konkers/cuttlefish/README.md

# Cuttlefish

A drawing of a cuttlefish

An [RP2040](https://www.raspberrypi.com/documentation/microcontrollers/rp2040.html)
based controller for the [LumenPnP Feeder](https://github.com/opulo-inc/feeder).

## Cloning

This repo uses submodule to pull in external dependencies and needs to be recursivly cloned:

```bash
git clone --recurse-submodules https://github.com/konkers/cuttlefish 
```

## PCB

The main pcb is designed in [KiCad](kicad.org).  Becase I use the experimental
HTTP Library support, a nightly version of KiCad is needed.

The [schematic](https://kicanvas.org/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) and
[layout](https://kicanvas.org/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)
can be viewed through KiCanvas.

### Front

front of the cuttlefish pcb 

### Back

front of the cuttlefish pcb

## Firmware

Firmware has not been written yet.  Check back for updates.
