konkers/cuttlefish/(list of files, cad)

Other CAD files:
pcb/main/board_outline.FCStd
