konkers/cuttlefish/pcb/main/cuttlefish-main.kicad_pcb

## KiCad design pcb/main/cuttlefish-main.kicad_pcb (2023-11-08)

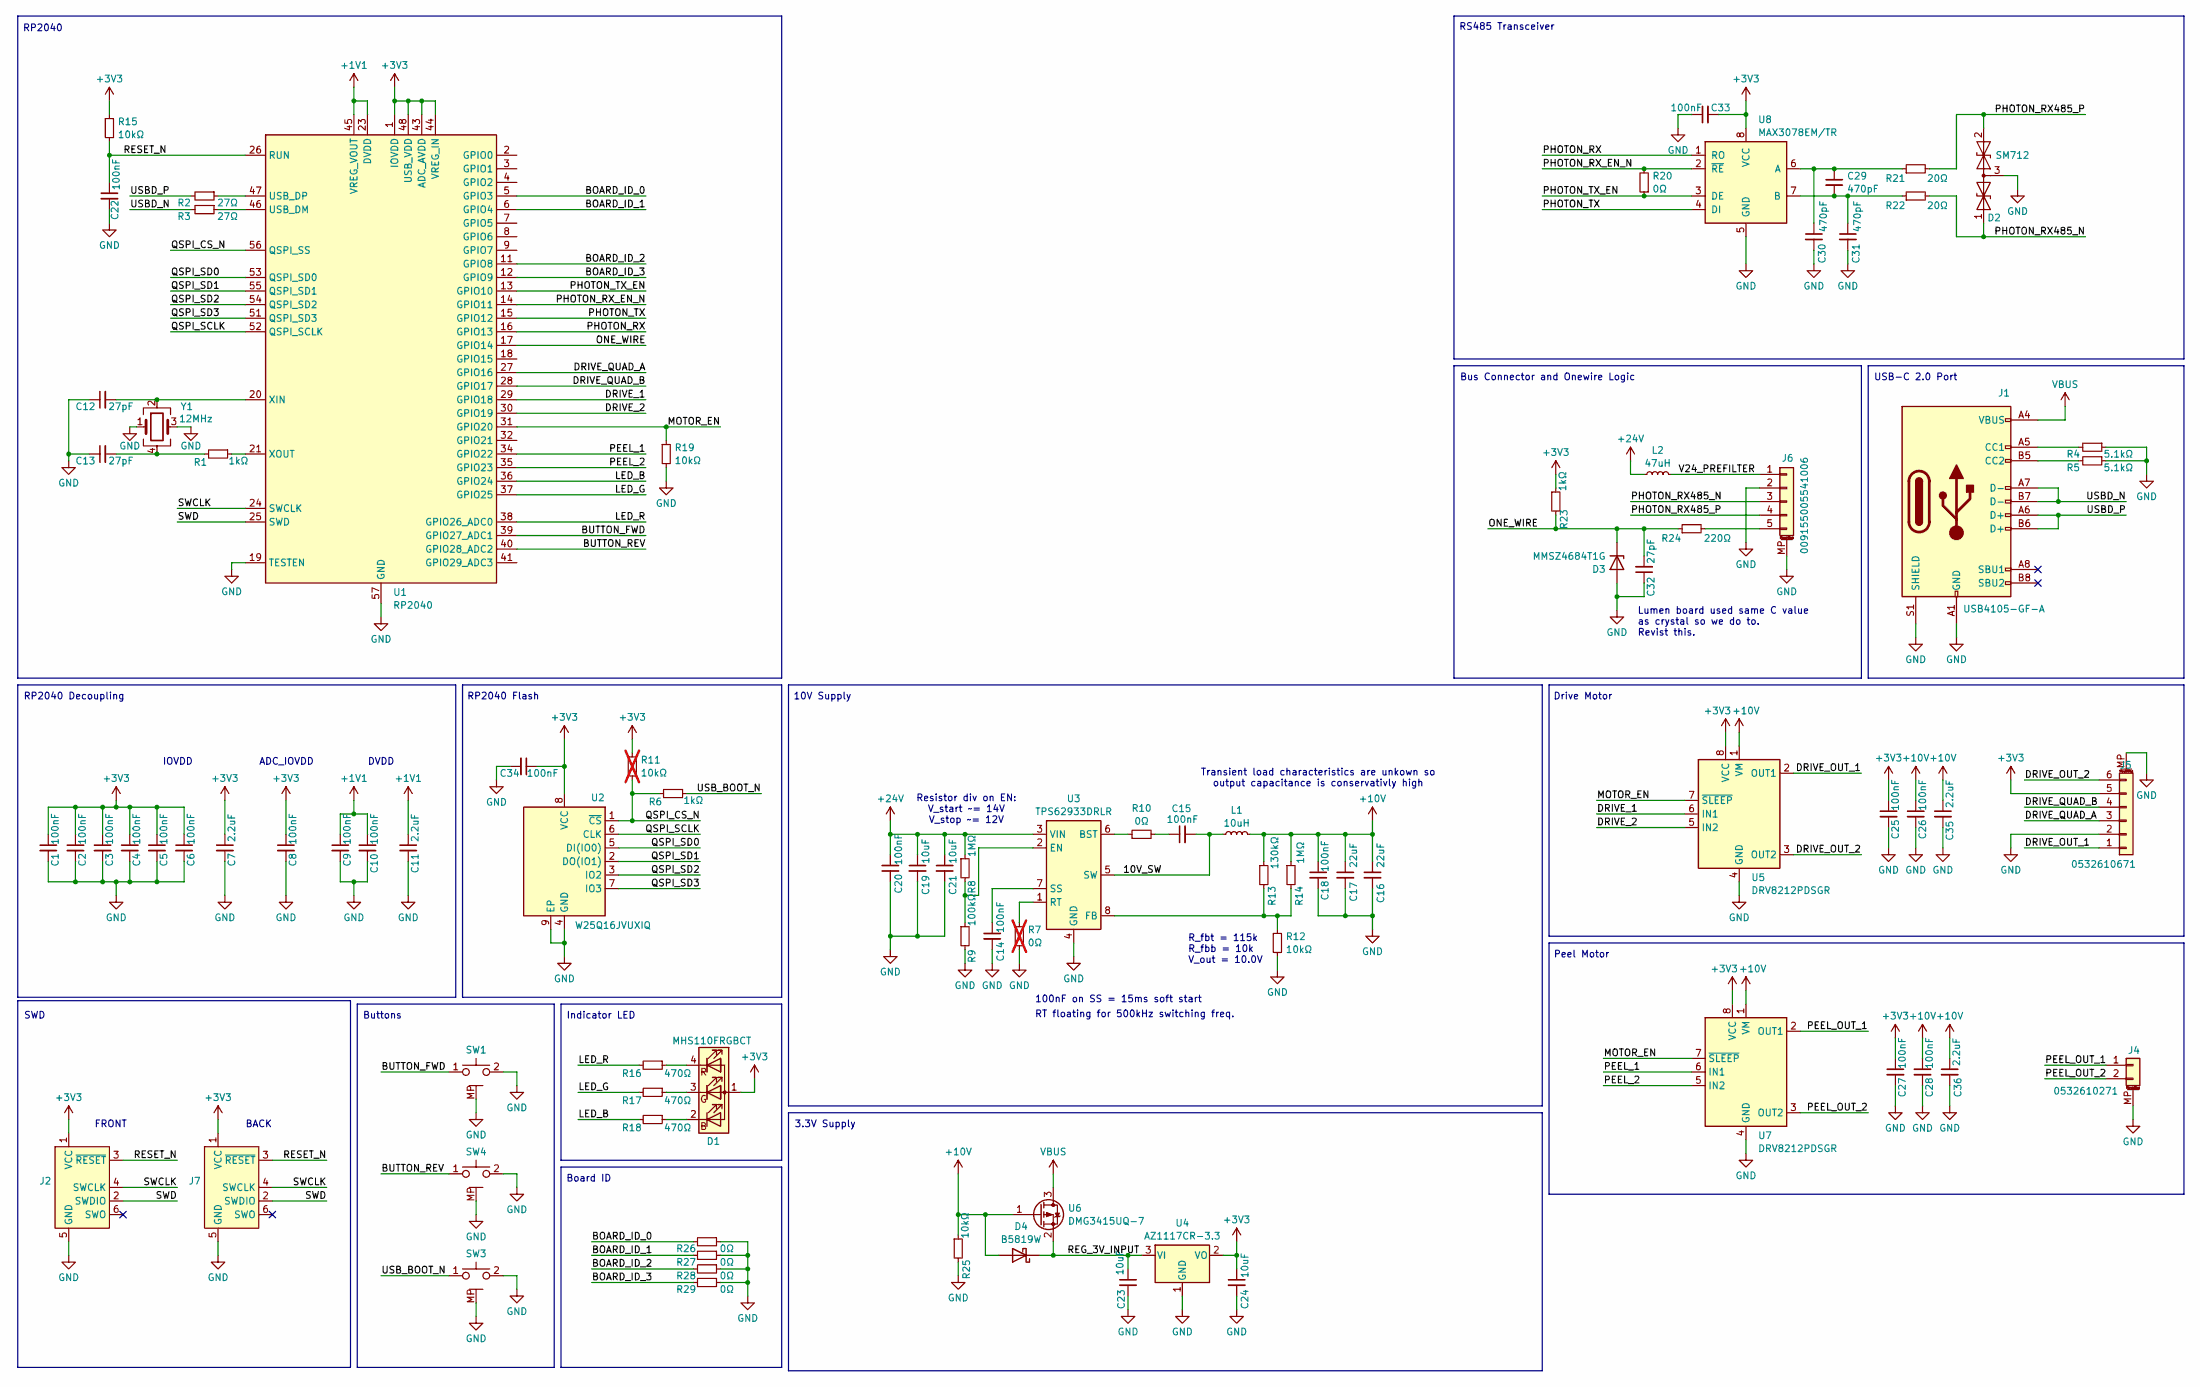
[picture p1: schematic cuttlefish-main.kicad_sch]

Parts:
C1, C2, C3, C4, C5, C6, C8, C9, C10, C14, C15, C18, C20, C22, C25, C26, C27, C28, C33, C34: 100nF; C_0402_1005Metric; Rated Voltage 50V; Tolerance ±10%; Part URL /part/12/
C7, C11, C35, C36: 2.2uF; C_0603_1608Metric; Rated Voltage 50V; Tolerance ±10%; Part URL /part/17/
C12, C13, C32: 27pF; C_0402_1005Metric; Tolerance ±5%; Part URL /part/6/
C16, C17: 22uF; C_0805_2012Metric; Rated Voltage 25V; Tolerance ±20%; Part URL /part/28/
C19, C21, C23, C24: 10uF; C_0603_1608Metric; Rated Voltage 35V; Tolerance ±20%; Part URL /part/29/
C29, C30, C31: 470pF; C_0402_1005Metric; Rated Voltage 50V; Tolerance ±10%; Part URL /part/39/
D1: MHS110FRGBCT; MEIHUA_MHS110FRGBCT; Part URL /part/33/
D2: SM712; SOT-23; Breakdown Voltage 13.3V; Clamping Voltage 21V; Part URL /part/41/
D3: MMSZ4684T1G; D_SOD-123; Forward Voltage 900mV@10mA; Rated Voltage 3.3 V; Part URL /part/45/
D4: B5819W; D_SOD-123; Forward Voltage 690mV@1A; Rated Voltage 40 V; Part URL /part/49/
J1: USB4105-GF-A; USB_C_Receptacle_GCT_USB4105-xx-A_16P_TopMnt_Horizontal; Part URL /part/15/
J2: Tag-Connect_TC2030-IDC-NL_2x03_P1.27mm_Vertical
J4: 0532610271; Molex_PicoBlade_53261-0271_1x02-1MP_P1.25mm_Horizontal; Part URL /part/37/
J5: 0532610671; Molex_PicoBlade_53261-0671_1x06-1MP_P1.25mm_Horizontal; Part URL /part/36/
J6: 009155005541006; AVX_009155005541006; Part URL /part/43/
J7: Conn_ARM_SWD_TagConnect_TC2030-NL; Tag-Connect_TC2030-IDC-NL_2x03_P1.27mm_Vertical
L1: 10uH; Inductor_SMD_7.0mm_6.7mm_2.8mm; Tolerance ±20%; Part URL /part/46/
L2: 47uH; L_Sunlord_SWPA5020S; Tolerance ±20%; Part URL /part/42/
R1, R6, R23: 1kΩ; R_0402_1005Metric; Tolerance ±1%; Part URL /part/7/
R2, R3: 27Ω; R_0402_1005Metric; Tolerance ±1%; Part URL /part/8/
R4, R5: 5.1kΩ; R_0402_1005Metric; Tolerance ±1%; Part URL /part/9/
R7: 0Ω; R_0402_1005Metric; Tolerance Jumper; Part URL /part/21/; not fitted
R8, R14: 1MΩ; R_0402_1005Metric; Tolerance ±1%; Part URL /part/24/
R9: 100kΩ; R_0402_1005Metric; Tolerance ±1%; Part URL /part/11/
R10, R20, R26, R27, R28, R29: 0Ω; R_0402_1005Metric; Tolerance Jumper; Part URL /part/21/
R11: 10kΩ; R_0402_1005Metric; Tolerance ±1%; Part URL /part/25/; not fitted
R12, R15, R19, R25: 10kΩ; R_0402_1005Metric; Tolerance ±1%; Part URL /part/25/
R13: 130kΩ; R_0402_1005Metric; Tolerance ±1%; Part URL /part/26/
R16, R17, R18: 470Ω; R_0402_1005Metric; Tolerance ±1%; Part URL /part/34/
R21, R22: 20Ω; R_0402_1005Metric; Tolerance ±1%; Part URL /part/40/
R24: 220Ω; R_0402_1005Metric; Tolerance ±1%; Part URL /part/44/
SW1, SW3, SW4: 1TS003B-2600-3500A-CT; HYP_1TS003B_2600_3500A_CT; Part URL /part/32/
U1: RP2040; QFN-56-1EP_7x7mm_P0.4mm_EP3.2x3.2mm; Rated Voltage 1.8~3.3V; Part URL /part/4/
U2: W25Q16JVUXIQ; USON-8-1EP_3x2mm_P0.5mm_EP0.3x1.7mm; Rated Voltage 2.7~3.6V; Part URL /part/18/
U3: TPS62933DRLR; SOT-583-8; Part URL /part/20/
U4: AZ1117CR-3.3; SOT-89-3; Part URL /part/47/
U5, U7: DRV8212PDSGR; WSON-8-1EP_2x2mm_P0.5mm_EP0.9x1.6mm; Rated Voltage 1.65~5.5V; Part URL /part/35/
U6: DMG3415UQ-7; SOT-23-3; Rated Voltage 20 V; Part URL /part/48/
U8: MAX3078EM/TR; SOIC-8_3.9x4.9mm_P1.27mm; Rated Voltage 3~3.6V; Part URL /part/38/
Y1: 12MHz; Crystal_SMD_3225-4Pin_3.2x2.5mm; Frequency Tolerance ±10ppm; Part URL /part/5/

Connections:
+1V1: C9.1, C10.1, C11.1, U1.23 (DVDD), U1.45 (VREG_VOUT), U1.50 (DVDD)
+3V3: C1.1, C2.1, C3.1, C4.1, C5.1, C6.1, C7.1, C8.1, C24.1, C25.1, C27.1, C33.2, C34.1, D1.1 (A), J2.1 (VCC), J5.5, J7.1 (VCC), R11.1, R15.1, R23.1, U1.1 (IOVDD), U1.10 (IOVDD), U1.22 (IOVDD), U1.33 (IOVDD), U1.42 (IOVDD), U1.43 (ADC_AVDD), U1.44 (VREG_IN), U1.48 (USB_VDD), U1.49 (IOVDD), U2.8 (VCC), U4.2 (VO), U5.8 (VCC), U7.8 (VCC), U8.8 (VCC)
+10V: C16.1, C17.1, C18.1, C26.1, C28.1, C35.1, C36.1, D4.2 (A), L1.2, R13.1, R14.1, R25.1, U5.1 (VM), U6.1 (G), U7.1 (VM)
+24V: C19.1, C20.1, C21.1, L2.1, R8.1, U3.3 (VIN)
/10V_SW: C15.2, L1.1, U3.5 (SW)
/BOARD_ID_0: R26.2, U1.5 (GPIO3)
/BOARD_ID_1: R27.2, U1.6 (GPIO4)
/BOARD_ID_3: R29.2, U1.12 (GPIO9)
/BUTTON_FWD: SW1.1, U1.39 (GPIO27_ADC1)
/BUTTON_REV: SW4.1, U1.40 (GPIO28_ADC2)
/DRIVE_1: U1.29 (GPIO18), U5.6 (IN1)
/DRIVE_2: U1.30 (GPIO19), U5.5 (IN2)
/DRIVE_OUT_1: J5.1, U5.2 (OUT1)
/DRIVE_OUT_2: J5.6, U5.3 (OUT2)
/DRIVE_QUAD_A: J5.3, U1.27 (GPIO16)
/DRIVE_QUAD_B: J5.4, U1.28 (GPIO17)
/LED_B: R18.2, U1.36 (GPIO24)
/LED_G: R17.2, U1.37 (GPIO25)
/LED_R: R16.2, U1.38 (GPIO26_ADC0)
/MOTOR_EN: R19.1, U1.31 (GPIO20), U5.7 (~SLEEP), U7.7 (~SLEEP)
/ONE_WIRE: C32.2, D3.1 (K), R23.2, R24.1, U1.17 (GPIO14)
/PEEL_1: U1.34 (GPIO22), U7.6 (IN1)
/PEEL_2: U1.35 (GPIO23), U7.5 (IN2)
/PEEL_OUT_1: J4.1, U7.2 (OUT1)
/PEEL_OUT_2: J4.2, U7.3 (OUT2)
/PHOTON_RX: U1.16 (GPIO13), U8.1 (RO)
/PHOTON_RX485_N: D2.1 (A1), J6.3, R22.2
/PHOTON_RX485_P: D2.2 (A2), J6.4, R21.2
/PHOTON_RX_EN_N: R20.2, U1.14 (GPIO11), U8.2 (~RE)
/PHOTON_TX: U1.15 (GPIO12), U8.4 (DI)
/PHOTON_TX_EN: R20.1, U1.13 (GPIO10), U8.3 (DE)
/QSPI_CS_N: R6.2, R11.2, U1.56 (QSPI_SS), U2.1 (~CS)
/QSPI_SCLK: U1.52 (QSPI_SCLK), U2.6 (CLK)
/QSPI_SD0: U1.53 (QSPI_SD0), U2.5 (DI(IO0))
/QSPI_SD1: U1.55 (QSPI_SD1), U2.2 (DO(IO1))
/QSPI_SD2: U1.54 (QSPI_SD2), U2.3 (IO2)
/QSPI_SD3: U1.51 (QSPI_SD3), U2.7 (IO3)
/REG_3V_INPUT: C23.1, D4.1 (K), U4.3 (VI), U6.2 (S)
/RESET_N: C22.1, J2.3 (~RESET), J7.3 (~RESET), R15.2, U1.26 (RUN)
/SWCLK: J2.4 (SWCLK), J7.4 (SWCLK), U1.24 (SWCLK)
/SWD: J2.2 (SWDIO), J7.2 (SWDIO), U1.25 (SWD)
/USBD_N: J1.A7 (D-), J1.B7 (D-), R3.2
/USBD_P: J1.A6 (D+), J1.B6 (D+), R2.2
/USB_BOOT_N: R6.1, SW3.1
/V24_PREFILTER: J6.1, L2.2
unnamed: C13.2, R1.2, Y1.4
unnamed: C15.1, R10.2
unnamed: D1.2 (BK), R18.1
unnamed: D1.3 (GK), R17.1
unnamed: D1.4 (RK), R16.1
unnamed: J1.A5 (CC1), R4.2
unnamed: J1.B5 (CC2), R5.2
unnamed: J6.5, R24.2
unnamed: R3.1, U1.46 (USB_DM)
unnamed: R2.1, U1.47 (USB_DP)
unnamed: C12.2, U1.20 (XIN), Y1.2
unnamed: R1.1, U1.21 (XOUT)
unnamed: R10.1, U3.6 (BST)
unnamed: R8.2, R9.1, U3.2 (EN)
unnamed: R12.1, R13.2, R14.2, U3.8 (FB)
unnamed: R7.1, U3.1 (RT)
unnamed: C14.1, U3.7 (SS)
unnamed: C29.1, C30.1, R21.1, U8.6 (A)
unnamed: C29.2, C31.1, R22.1, U8.7 (B)
VBUS: J1.A4 (VBUS), J1.A9 (VBUS), J1.B4 (VBUS), J1.B9 (VBUS), U6.3 (D)

Notes on the sheet:
RP2040
ADC_IOVDD
Board ID
3.3V Supply
R_fbt = 115k R_fbb = 10k V_out = 10.0V
IOVDD
SWD
RP2040 Flash
Drive Motor
Lumen board used same C value as crystal so we do to. Revist this.
RT floating for 500kHz switching freq.
100nF on SS = 15ms soft start
RP2040 Decoupling
Bus Connector and Onewire Logic
DVDD
Resistor div on EN: V_start ~= 14V V_stop ~= 12V
Transient load characteristics are unkown so output capacitance is conservativly high
USB-C 2.0 Port
Buttons
10V Supply
RS485 Transceiver
Indicator LED
Peel Motor
FRONT
BACK

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
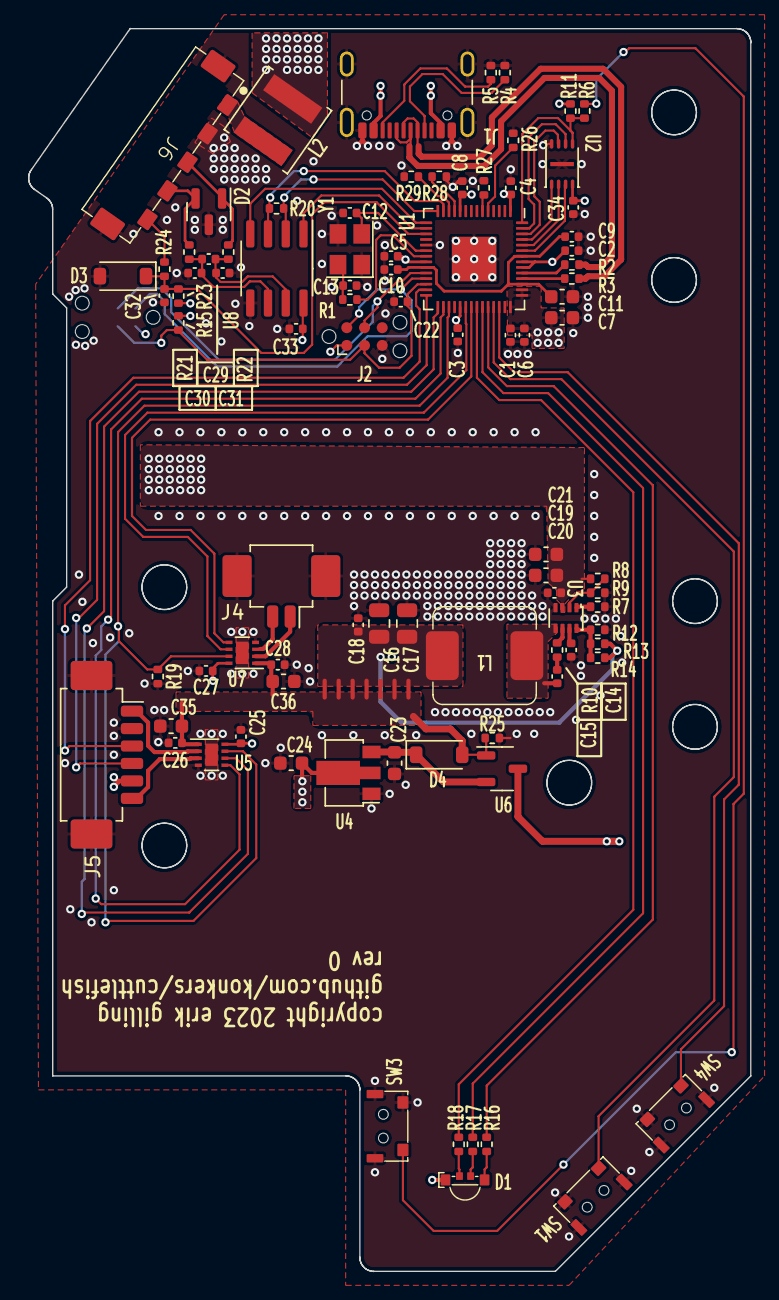
[picture p2: board cuttlefish-main.kicad_pcb from above]

Board: 4 copper layers, 51.7 x 89.0 mm, 89 parts (1 on the bottom side), 67 nets.
