konkers/cuttlefish/(commit log)

2023-10-30 pcb/main initial schematic capture
    [feeder2040.kicad_pcb, feeder2040.kicad_sch]
2023-11-03 First pass at routing complete
    [board_outline.FCStd, feeder2040.kicad_pcb, feeder2040.kicad_sch]
2023-11-08 Almost ready for rev0 fab
    [cuttlefish-main.kicad_pcb, cuttlefish-main.kicad_sch]
