konkers/cuttlefish/(notices)

Notices in the files:
pcb/main/cuttlefish-main.kicad_pcb:
copyright 2023 erik gilling
